XXXStars0/Project-Jack-in-a-Box/Jack/keys_template.h

// Personal Wifi and Trello API keys
// Keep Private
// Wifi Configuration
#define SECRET_SSID "Your WiFi Name"
#define SECRET_PASS "Your WiFi Password"

// Trello API keys
#define TRELLO_API_KEY "Your Trello API Key"
#define TRELLO_TOKEN "Your Trello Token"
#define TRELLO_BOARD_ID "Your Trello Board ID"
