XXXStars0/Project-Jack-in-a-Box/(commit log)

2026-03-22 Net connection fix and RedRover support
    [Jack.ino, keys_template.h]
2026-03-22 Added servo control for Jack-in-a-Box project with document and design update.
2026-03-22 Modified code, removed wired link function and updated README for Wi-Fi-only operation
2026-03-23 Added laser cutting designand. Updated README with basic assembly, detailed usage, and troubleshooting guides.
